kaloprojects/KALO-ESP32-Voice-Chat-AI-Friends/(threads)

Thread 1 (2025-03-06):

Contribution Request: Enhanced Version of Your ESP32 Voice Assistant

palashis92, 2025-03-06:
Hi Kalo,

I hope you're doing well! I wanted to thank you for your amazing ESP32 ChatGPT voice assistant project—it works great, and I really appreciate the effort you put into it.

I’ve built my own version based on your project but with a few modifications to make it more accessible, especially in countries where accessing OpenAI’s paid API is difficult. Here’s what I changed:

LLM: Switched from ChatGPT to DeepSeek (free from GroqCloud).

STT: Replaced DeepGram with Erevan Labs Scribe V1—it's faster, more accurate, and supports 90+ languages.

TTS: Used Google TTS but solved its response length limitation by adding a speakTextInChunk function.

Live Information: Integrated function calling to fetch real-time data (time API, news API, Google search).

Home Automation: Added IoT control for smart home devices (e.g., turning lights on/off via voice commands).

I would love to share my version with the community by contributing to your GitHub repository. Let me know if you’d be open to it!

Additionally, I’ve been trying to implement a wake word feature but haven’t been able to get it working yet. I was wondering if you had any plans to add wake word support in the future—it would be an awesome addition!

Looking forward to your thoughts. Thanks again for your great work!

Best regards,
Jahidul Islam Palash

kaloprojects, 2025-03-11:
Hi Jahidul,
(sorry for the late response, I was on travel last week)

Cool !, this sounds awesome .. and YES of course: Please share your project, contributing to my Github, feel free to use any snippets from my code. Post the link to your Github here, very welcome.

Personally I am curious to see 1. your STT alternative (do you mean 'Eleven Labs STT ?) and 2. Live information idea, some notes/comments:

- STT (accuracy) : Deepgram is multilingual too, but what i learned is that the accuracy is much better when limiting to a dedicated language (means avoiding '&detect_language=true'). Which makes sense .. because how should STT know which language is meant in particular on short phrases like 'Hi', right ?. Is it same in  Eleven Labs Scribe ? and what about costs for API key ?
- STT (speed): Interesting to hear that your idea is even faster than Deepgram. My observation is that Deepgram transcription (on prerecorded audio) is fast already (mostly 1 sec) .. the problem i have is the delay for sending the wav audio (because the ESP32 SD card needs about 2 sec for reading/sending on 16K/8bit). So the main delay (SD access) sill exists in your alternative, right ?
- Live information: Cool !, exited to see. I also added this in my internal version (not shared), using Perplexity LLM on demand (via key word) instead Open AI, but the problem is the high costs (about 20$ per month).  So let us know how you call Google Search via API.
- wake word: No, i did not add any wake word (even not planned), due a simple reason: I have to press a button anyhow on recording, because sending prerecorded audio to STT (instead streaming). Well knowing that a ESP32 native C solution with streaming to Deepgram would be best solution anyhow.

So go ahead .. send us the link to your enhance version :) !. Cool !

Thx
kalo

kaloprojects, 2025-03-19:
Hi @palashis92 : any news  .. anything you could share ?
btw: i just made an update some days ago, now supporting some 3rd party hardware ready to go ;)

palashis92, 2025-03-19:
Hi Kalo,

Thanks a lot for your encouraging reply, and sorry for the delay—I was caught up with an exam.

STT (Accuracy):
I’m using Erevan Labs Scribe V1 as my STT alternative. I’ve observed that while it supports multiple languages well, much like Deepgram, its accuracy does improve when a dedicated language is specified rather than relying on automatic detection. This is particularly noticeable with short phrases (e.g., "Hi" vs. "nein") where context is limited. On the cost front, the API key for Erevan Labs Scribe V1 is free, which is a big plus for regions where paid API access is a challenge.

Live Information (Real-time Research):
This feature is still experimental on my end. I’m currently facing an issue where the ESP32 restarts automatically after retrieving results from Google Search. I haven’t been able to stabilize this part yet, so I can’t share the code at the moment. I’m actively working on a fix and hope to have it sorted soon.

Home Automation:
I’ve also implemented home automation similar to your demo with the 'radio' keyword. In addition, I integrated both time and news APIs to extend the functionality, making it a more comprehensive control feature for smart home devices.

TTS (Google):
Unlike your experience with Google TTS, I found that it works great in my setup. I tackled the response length limitation by adding a speakTextInChunk function, which seems to handle longer texts efficiently.

I’m excited to share my project With You .
Here It Is: https://drive.google.com/file/d/1d128NDZqOsqkAePbMw_JK4VENjFxqsQH/view?usp=sharing

A quick note on the code itself—I didn't change the variable and function names because I encountered many errors when I tried renaming them.

Looking forward to hearing your thoughts and any suggestions you might have. Thanks again for your great work and support!

Best regards,
Jahidul Islam Palash

kaloprojects, 2025-03-19:
Hi Jahidul,

Great !, thank you for the fast and detailed response, very welcome.

Live Information/Google Search API: in past i learned often how 'sensitive' the ESP32 is on opening any wificlientsecure instances, maybe its the same you are struggling in. What helped often: make sure you closed any other socket connections (e.g. Deepgram or your SST and Open AI) before launching other Goggle API. Just mentioning, no idea this hint helps as i can't see your code details.

I tried to open your sketches from Google cloud, i can download a rar file, but on opening it tells me 'no valid rar file'. I tested with several PC's, same, so maybe something on your side ? Maybe you could double check, otherwise feel free to attach the zip here

Thanks ! . cheers ;)
kalo

kaloprojects, 2025-03-19:
I could open .. used web RAR viewer ;)

great details in your modified code ... well done!. I love to see such ideas, and happy to that my code have helped. Seen some videos, telling me that Crog server LLM is much faster than Open AI too, right ?. I will check in Playground next.

Let us know the progress on your Goggle Search API , Live Information would be a great enhancement (i love my internal Perplexity add-on, works best, also Open AI API compatible, but I might skip due the high monthly costs as soon we have an alternative).

Good luck on next steps !, we'll stay in touch
kalo

kaloprojects, 2025-04-06:
Hi @palashis92 , i might have some news of interest for you:

Check my latest update from today (April 4, 2025), _i added a native 'Live Information (Real-time Research)'_ into my code ;)
No longer any (expensive) LLM alternatives (e.g. Perplexity) needed, neither any separate Google Search API calls.

Workflow insights: latest code update supports the _new_ Open AI model 'gpt-4o-mini-search-preview' (on top to default 'gpt-4o-mini'), using same OpenAI API key (no additional monthly costs). Workflow: Code is triggered by a key word, i am using word 'Question' in begin of user request (just as an example). And maybe most helpful: any realtime searches are part of the same chat history (following up questions supported)

Hope this helps, enjoy! .. and let us know your thoughts ;)

palashis92, 2025-04-10:
Hi Kalo

Thanks a lot for your mail bro. I just saw your update and honestly—it’s amazing! You really solved the problem I was stuck on. Real-time info without Google Search or Perplexity? That’s just awesome! I really appreciate your work. I’ll definitely try it out after my exam.

Sorry for the late reply. My final exam is going on so I was kind of offline. Also… the day you sent the mail, I had a breakup. So yeah, life’s been really hard lately. Don’t know why I’m sharing all this, but just felt like it.

But still, your project gave me some motivation. I’ll check it properly soon and send you feedback. And I’m also trying to improve your project from my side. Just needed some time to restart.

And one more thing… I wanna see you bro. If possible, let’s connect sometime.

Take care & thanks again 💙
Palash

palashis92, 2025-05-12:
Hey @kaloprojects ,

I just finished my exams and started testing your newly updated project. However, I’m facing a problem that I couldn’t figure out myself.

The issue is with OpenAI TTS — it's not working properly. I can’t hear any audio output from the speaker when using OpenAI’s text-to-speech. But when I use gTTS, it works fine. Also, playing songs from the SD card works perfectly, so it’s not a speaker issue.

**Here’s the code I’m using to test OpenAI TTS (including the API request and audio playback):**

if (LLM_Feedback != "")
{
    led_RGB(HIGH, LOW, LOW); // CYAN
    String Voices[9] = { "alloy", "ash", "coral", "echo", "fable", "onyx", "nova", "sage", "shimmer" };
    String Voice = Voices[random(9)];
    if (favorite_VOICE != "") { Voice = favorite_VOICE; }

    Serial.println("OpenAI Voice = [" + Voice + "]");
    Serial.println("Starting OpenAI TTS with AAC...");

    audio_play.setVolume(21); // Max volume to rule out volume issues
    audio_play.openai_speech(OPENAI_KEY, "tts-1", LLM_Feedback.c_str(), Voice, "aac", "1");

    if (audio_play.isRunning()) {
        Serial.println("TTS audio is playing");
    } else {
        Serial.println("TTS audio failed to start");
    }

    unsigned long startTime = millis();
    while (audio_play.isRunning() && millis() - startTime < 10000) { // Timeout after 10s
        audio_play.loop();
        Serial.println("Playback running, free heap: " + String(ESP.getFreeHeap()));
        delay(1000);
    }

    Serial.println("TTS playback stopped, final heap: " + String(ESP.getFreeHeap()));
}

**Console Output:**

OpenAI LLM> .......... [Hey there, PALASH! 😊 How’s it going with you today? Got any fun stories or]
OpenAI Voice = [coral]
Starting OpenAI TTS with AAC...
TTS audio is playing
Playback running, free heap: 98976
TTS playback stopped, final heap: 99204
Everything seems fine in the logs — it shows the TTS audio is playing — but there’s no sound from the speaker.

**As for your question:**
Where did I find the ElevenLabs HTTPS multi-bounding messages trick?
Well, I didn’t pull it directly from the internet or use code snippets. I built and modified everything in this project with help from ChatGPT.

And by the way — can you share your project with me? I'm super excited! 😄
I’ve got my school science fair on April 14th, so I need to work fast and would love to get started as soon as possible.

Thanks again for the awesome work!

Would you like me to help debug the TTS issue too?

palashis92, 2025-05-12:
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

kaloprojects, 2025-05-12:
Hi ;)

there were no changes .. all what mentioned earlier in readme.md is still valid

_Required (for i2s_std.h): Arduino IDE with _ESP32 lib 3.1.x_ (based on ESP-IDF 5.3.x). Older 2.x ESP (i2s.h) are not supported.
Required (for TTS): [AUDIO.H library ESP32-audioI2S.zip](https://github.com/schreibfaul1/ESP32-audioI2S), version 3.0.11g or newer._

I am using Arduino IDE 1.8.19 (but that's because this is the latest version supporting Windows 7), but also newer 2.0 version work well with the published code. Knowing this as some friends using my code (without changes and working there too). It is more important that ESP32 lib 3.1.x or newer is installed, but i am sure you have this already, otherwise the complete recording won't work.

In Audio.H also no changes happend (see my comment on header needed (3.0.11g or newer, July 18, 2024) needed for 8bit wav recording, you will have this already. I am using the latest _3.1.0w from April 28_ .. but only because i wanted to have the isRunning() bug fixed, now openai_speech() works perfect. The side effect on this latest AUDIO.H update is only that a 4rd parameter now needed (which is good, was a reason more why i updated).

Lets do this: maybe you post a tiny few line (but complete!) which works well on your laptop (using Google TTS  audio.connecttospeech(..) here (just remove your credentials) .. then i will test your sketch 1:1 on my laptop (and replacing audio.connecttospeech(..)  with openai_speech(..) instead google. Makes sense ?

kaloprojects, 2025-05-13:
Hi @palashis92 ,

something totally different came in my mind, maybe test this:

I remember long time ago i had one ESP32 which often skipped any audio output via .openai_speech(). All worked well in code .. but nothing came out from speaker. The reason was pretty strange: this ESP32 struggled because power/wlan issues.
reasons: sensitive on powering supply and wlan strength. I used another  (active) usb hub, a better usb cable and moved device closer to my wlan hotspot, then all worked flawless. Maybe the handshake with Open AI TTS server is pretty sensitive and this was the root cause at the end. No idea, but this solved all stability issues, and speaker working flawless.

So maybe check this first: try a different usb port / better cable / make sure the wlan strength is strong ;)

kalo

kaloprojects, 2025-05-13:
oh, final question from my side:
I might test your side note once _(LLaMA via Groq Cloud, and interestingly, its response time has been noticeably faster in my tests—usually around 1–2.5 seconds compared to GPT’s 4–5 seconds)._ .. but let me know: Meanwhile i use the Live Information (Real-time Research)' from Open AI often, slow but awesome, need it daily .. but for this the Open AI model"gpt-4o-mini-search-preview" is needed. Has Croq Cloud a similar model for web search ??

chhorisberger, 2025-05-13:
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

I'll put in my two cents here, since I noticed the same issue. For me it seems to only happen when i call SD.begin(). As soon as I remove the SD.begin from the code, I can here the voice correctly.

Of course the rest of the code won't work then :/ but one more reason to eagerly await @kaloprojects version that uses PSRAM instead of the SD card.

palashis92, 2025-05-14:
Hey @kaloprojects
Groq Cloud doesn't currently offer live search like OpenAI’s gpt-4o-mini-search-preview, I was thinking of using both models together:

Use Groq Cloud’s LLaMA for fast and free text generation tasks (chat, summarization, reasoning, etc.),

And use OpenAI’s live search model when I need real-time information from the web.

This way, we could get the speed advantage of Groq plus the up-to-date accuracy of OpenAI search. What do you think of that approach? Would love to hear your take on combining the two like this.

chhorisberger, 2025-05-14:
Hi @palashis92
Nice to hear!
Actually I don't have the Kalo code that uses PSRAM for audio recording code either, so I still use the SDcard at the moment.

But just running the "as is" version of kalo on a esp32 with PSRAM does allow the audio library to make use of use it, which then in turn allows the SDcard to be used without running out of heap space.

palashis92, 2025-05-14:
Hi @kaloprojects
sorry to bother you!

Actually I'm currently struggling with the hardware setup. Since I don’t have a proper PCB, I’ve been using direct jumper wire connections, and it’s honestly becoming a huge headache. The wiring often fails or becomes unstable, making it really hard to test or debug consistently.

Would it be possible for you to share the PCB design or Gerber files for the project? It would help a lot and save a ton of time and frustration on the hardware end.

Thanks again for your awesome work, and sorry once again for the trouble!

palashis92, 2025-05-14:
> Hi [@palashis92](https://github.com/palashis92) Nice to hear! Actually I don't have the Kalo code that uses PSRAM for audio recording code either, so I still use the SDcard at the moment.
>
> But just running the "as is" version of kalo on a esp32 with PSRAM does allow the audio library to make use of use it, which then in turn allows the SDcard to be used without running out of heap space.

Wow, thank you so much for explaining it so kindly!

kaloprojects, 2025-05-15:
Hi folks,
cool thread ;) .. just let me add a brief answer (keeping short, because pretty busy in moment and have to focus on my code to get it ready asap for you guys ;)

- @chhorisberger nice observation regarding SD.begin(). interesting. 👍 But you know what: i am still pretty sure a improved Vcc power supply will solve it. Saying this because i remember some Internet threads where the mentioned that the Init of SD card (via SD.begin) consumes some power peaks. I know it sounds crazy, but test some other usb cable and usb ports. Reason i am saying this: openai_speech() and SD card togehter should work flawless (and it does on my projects!). And they are compatible, both is handled via same AUDIO.H from schreibfaul1 ;)
- @palashis92: Meanwhile i do not use any own pcb any longer .. i am using this techiesms's pcb, i love it, works best (no SD issue) and best: it has a battery circuit, so this tiny pcb works mobile. And the included battery solved all pains: Maybe check here, ordering one, it works with my code on gitbub 1:1 (no changes needed, just using (#define TECHIESMS_PCB  true): techiesms's hardware/pcb [Portable AI Voice Assistant](https://techiesms.com/product/portable-ai-voice-assistant/). It does not have PSRAM, but with my upcoming code it is nearly same fast as with PSRAM
- Latency Open Ai vs. Groq: I just have an idea how i can improve the speed of Open AI further, so maybe no longer need of any Groq work around. Give me 2 days more for testing, maybe i will add the idea also in upcoming code update (in few days i hope)

I try my best to get the updated code ready asap, the upcoming weekend might give me the chance to finalize, stay tuned 😊

palashis92, 2025-05-16:
Hey @kaloprojects ,
Sorry for the late reply — you mentioned you were busy, so I didn’t want to interrupt.

Actually, you're right. @chhorisberger’s suggestion solved my SD card issue. But I still notice that openai_speech() misses responses quite often. Also, I’m not using any capacitors — I don’t have much hardware knowledge, so that might be the reason.

One major weak point I’ve noticed is that this project works great in a quiet environment, like my room. But it performs poorly outdoors or in noisy places like my classroom — even when I use GAIN_BOOSTER_I2S 64.Is there any way we can improve the microphone performance to handle noisy environments better, like how Alexa or Google Assistant does? Maybe with noise suppression or a better mic setup? Would love to know your thoughts or any suggestions for a more robust solution.

Another issue is power drain — it consumes a lot of power when playing music from the SD card. Currently, I have to use specific commands to play specific songs. I was wondering — is it possible to stream music directly from Spotify or the internet instead of using the SD card?

Also, I’m a bit confused about the difference between SPIFFS and PSRAM. Recently, my SD card module started showing "SD card mount failed", so I removed it and switched to SPIFFS. That worked perfectly with my code using LLaMA and gTTS. But when I try uploading your recent or previous code (which uses GPT and openai_speech()), the ESP32 keeps rebooting repeatedly.

Lastly, I tried to stream audio output to my Bluetooth headphones/speaker as you mentioned — but I ran into lots of errors. Is that even possible with the current setup?

Looking forward to your insights!

palashis92, 2025-05-18:
@chhorisberger Are you Alive?

chhorisberger, 2025-05-19:
@kaloprojects thanks for the update! In the meantime I have now also upgrade to a esp32 with PSRAM and can confirm thst it works fine (at least with the 3.1.0w library). Thanks actually ditched the SD card completely now and changed the code myself to do recording to a buffer in psram before uploading to scribe STT as well. Works like a charm. Since i am planning to use it as part of a bigger project with more hardware integration, I am currently also refactoring the code to make it more of library (think fine state machine with optional inputs and outputs that can be "plugged in") If you're interested in looking at the idea, let me know

kaloprojects, 2025-05-20:
@chhorisberger : Cool 😊 ! , nice to hear. yes, the 3.1.0w works perfectly, unfortunatly it is not possible (for other user) to download this AUDIO.H version from github, right ?.

ooh just came in my mind: Can you once try to disable PSRAM in Arduino IDE menu and compile (just skip your PSRAM calls for testing), then you will see that AUDIO.H still causes a crash on booting (also eith the 3.1.0w). Is this same on your side ? Asking as i feel that there is still a bug in AUDIO.H, feels like for me that AUDIO.H always using PSRAM meanwhile, even if disabled .. then it crashes. Can you check once on your ESP32 with PSRAM?

palashis92, 2025-05-22:
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

Hi Kalo
Thanks a lot for the update — I can really feel how deep you’re going into this! 😅 You're putting in some crazy effort, and I truly appreciate it.

Honestly, I’m waiting for your updates so hard . I’ve been checking in daily, hoping to see any progress or workaround!

Just wanted to add some of my experience here too:
Your project works great with audio.h 3.1.0w, but I’m unable to find that specific version on GitHub anymore.
You mentioned it runs perfectly with ESP32 with PSRAM, but unfortunately, my ESP32 doesn’t have PSRAM, so I’m kinda stuck there

Also, at the moment, I’m using SPIFFS to store audio, since SD gave me a lot of headaches — constant read errors, unstable mounts, etc.
Do you think I really need to switch back to SD for proper compatibility? Or is SPIFFS enough for now (if optimized)?

Any small update, workaround, or tip would be super appreciated
Big respect for all your hard work!
Take your time — but just know that we’re out here cheering for you and your magic code to come through soon!

kaloprojects, 2025-05-22:
some progress with partially good news ;)
.. _meanwhile (5 mins ago)_ i found a library combination (all libraries updated to latest version incl. ESP Arduino latest 3.0.2) where ALL (!) audio events works with AUDIO.H (SD card ! + Google TTS + Open AI TTS + radio streaming), working well togheter. Means: that's a proof that any SD.begin() are NOT critical ... and Open AI voice speaks always (in speaker). 😊
Libraries: ESP32-audioI2S-3.2.0 / arduino-esp32 v3.2.0 (ESP-IDF v5.4.1 3.2.0)

the bad news: still PSRAM needed (without PSRAM AUDIO.H crashes) .. but that's a still ok, because allows me to follow up with Schreibfaul1 next ;)

kaloprojects, 2025-05-24:
Cool 😊 .. my compliment 👍
Fyi: i just removed your code, because seen some private API keys from you inside (better remove before other folks catch it). I will comment in more details later on .. (just busy myself with ongoing bug fixing in AUDIO.H), see you folks later ;)

kaloprojects, 2025-05-26:
> some progress
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

Thread 2 (2025-05-12):

Feature Request - PSRAM instead of SD card

chhorisberger, 2025-05-12:
First of all, great work and thank you so much for sharing this!

I just read your comment regarding the usage of PSRAM

`Update (April 28, 2025): Good news: PSRAM working well (on my internal updates), no longer need of a SD card, but unfortunalty speed of STT not significantly improved, bottleneck seems an issue in ESP32 WifiClientSecure.write(). I will discuss my tests with Espressif ESP32 folks next. Ongoing.`

Is there any chance you could release that functionality any time soon? I  currently working on building a tiny version of Kalos and would gladly ditch the SD card for space constraint reasons, if possible...

Many Regards
Christian

kaloprojects, 2025-05-12:
Hi, was on my todo list already. Code working well, just doing some cleanup .. AND (that's why i'll need some more days):
The latest code will also add an additional STT (ElevenLabs Scribe) as alternative to Deepgram.  Reason: This STT will be much faster on PSRAM (my lessons learned in current testings: Deepgram does not profit much from PSRAM, ElevenLabs does. Btw: Elevenlabs API key for STT is also free (for a limited amount of  h/min per month).

As long your ESP32 has PSRAM then SD card no longer needed.
I will update my code in few days (estimate: in ~ 1 week) 😊

Closed 2025-07-12.

Thread 3 (2025-07-04):

Awesome Library - Need Some Help With Setup

RWBRWB, 2025-07-04:
This looks like exactly what I'm looking for so excited to find this library for the ESP32 S3 Wroom with PSRAM.

I've tried to get this working along with the help of GPT on the code but I can't get it to compile successfully yet so I wanted to reach out for some help and I'm not sure where else I can ask this question.

I have the ESP32 Wroom S3 16Mb Flash + 8MB PSRAM + Same Microphone & I2S Amp that your using.

The library seems pretty simple but still I'm having issues.

I followed instructions in to a T I feel like but I'm getting this I2S setup error after loading the code to the ESP32 S3 Wroom 1 with 16mb + 8mb PSRAM.

SPIWP:0xee
mode:DIO, clock div:1
load:0x3fce2820,len:0x118c
load:0x403c8700,len:0x4
load:0x403c8704,len:0xc20
load:0x403cb700,len:0x30e0
entry 0x403c88b8
E (1021) i2s_std: i2s_std_set_gpio(153): ws invalid
E (1023) i2s_std: i2s_channel_init_std_mode(235): initialize channel failed while setting gpio pins
E (1032) i2s_common: i2s_channel_enable(1165): the channel has already enabled or not initialized

I have the newest Audio.h library downloaded and imported to the Arduino IDE so thats good.

I made all changes as described in the docs for PSRAM ESP32 S3 Wroom devices, switched to use PSRAM = True and SD Card = False.

It compiles just fine so not sure what's up. I have spent hours with it and trouble shooting with GPT & Claude Ai but no luck but I feel like I'm close.

Do you have a zipped up folder of the working project you could share that I can compile and run on my end successfully mins your API keys of course LOL.

Really looking forward to testing this out and helping expand the part where you can get the TTS return to trigger functions and also get function calls working the GPT replies so it can trigger actions based on it's reply also.

Any help getting past this error is appreciated. I've commented out the Mic input setup and the i2s amp output setup but I still see this same error.

Let me know if you have any questions.

Thanks!

RWBRWB, 2025-07-05:
Is there any way you could share a Zip file of your Arduino Code folder for your setup using the ESP32 WROVER just so I can compare what your working with vs what I'm using here?

I have the code running on my ESP32 WROVER with PSRAM but it looks like the string that sends request to Open AI GPT are not created properly so it never even sends a request to GPT. I have my API key loaded but see zero recent request to the API from the ESP32 after Elevenlabs successfuly does the audio transcription and then tries to send to OpenAI LLM but then fails.

The first connection when the ESP32 Starts up fails also.

Not sure if this is the latest Audio.H causing this or not but I'm doing my best to figure it out with the help of GPT.

If you could provide your working code for the ESP32 Rover with PSRAM then I can just compare what I got with what you have and try to find it without wasting to much of your time.

Seems like everything is working other than the request to Open AI and that looks like it's an issue with how the URL string request it being created on my end. I'm starting from scratch again to try to make sure I'm following your instructions as closely as possible but wanted to ask if you could share your code to help me along.

Not sure if your running the latest Audio.h file or not, not sure if anything has changed with the API so if you can try your device now and confirm it still works just fine that would confirm that or not.

Thanks for your feedback in advance!

RWBRWB, 2025-07-05:
Can you provide a zip folder of the working code you have for the ESP32 WROVER + PSRAM so I can try to make it work on my end also.

I have tried alot of different things so far and am getting to know your library functions better.

Currently the issue I'm having is that it's transcribing the audio recordings with Elevenlabs just fine.

Then it sends that or supposedly sends that transcribed text to OpenAi for a response but it never shows a response.

I created a new Open AI Key and at first it says the API key has never been used, then after I run your code and get a audio recording trascribed via Eleven Labs it comes back successfully and then the OPENAI function runs and the API is detected as used via the OpenAI Dashboard so I can confirm it's using my API key to connect to OpenAI but I don't see any result from OpenAI for some reason and I don't see any error messages also.

I'm using the latest Audio.H library and have tried the earlier ones also with the same results. I'm using the latest Arduino IDE and have tried older ESPIDF versions and newer ones with the same effect.

Is your main device still working as expected? Not sure if any changes have been made to the API.

I've tried using other GPT models but it makes no difference.

Pretty cool to see the Eleven Labs STT working so well and fast, that's useful alone but really looking forward to getting the GTP feedback up and working also.

Here is the serial output I get when I run your code on my end:

ets Jul 29 2019 12:21:46

rst:0x1 (POWERON_RESET),boot:0x17 (SPI_FAST_FLASH_BOOT)
configsip: 0, SPIWP:0xee
clk_drv:0x00,q_drv:0x00,d_drv:0x00,cs0_drv:0x00,hd_drv:0x00,wp_drv:0x00
mode:DIO, clock div:1
load:0x3fff0030,len:4980
load:0x40078000,len:16608
ho 0 tail 12 room 4
load:0x40080400,len:3480
entry 0x400805b4

== KALO ESP32 Voice ChatGPT (last update: June 28, 2025) =================================

> I2S_Recording_Init - Initializing Recording Setup:
- Sketch Size: 1510848
- Total Heap:  318612
- Free Heap:   230788
- STACK Size:  8192
- Flash Size:  16777216
- Total PSRAM: 4194304
- Free PSRAM:  4192124
> ps_malloc(): 2096062 (allocating 50% of free PSRAM for Audio)
> PSRAM maximum audio recording length [sec]: 131

> Connecting WLAN .... Done, device connected.
AUDIO.H info: audioI2S Version 3.3.2b

OpenAI SPEAKING, Voice = [onyx]
AUDIO.H info: PSRAM found, inputBufferSize: 630773 bytes
AUDIO.H info: buffers freed, free Heap: 178544 bytes
AUDIO.H info: Connect to: "api.openai.com"
AUDIO.H info: SSL has been established in 748 ms

Workflow:
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

==========================================================================================

-> Latency sending WAV file [t_wavbodysent]:   0.12
-> Latency ELEVENLABS response [t_response]:   0.76
=> TOTAL Duration [sec]: ..................... 1.50
=> Server response length [bytes]: 1566
=> Detected language (optional): [eng]
=> Transcription: [What time is it?]
---------------------------------------------------

[What time is it?]
OpenAI LLM> .
--------------------------------------------
Open AI LLM - model: [gpt-4.1-nano]
-> Latency Open AI Server (Re)CONNECT:  0.66
-> Latency Open AI LLM Response:        0.26
=> TOTAL Duration [sec]: .............. 0.92
--------------------------------------------
Open AI LLM>
> WAV Header in PSRAM generated, Audio Recording started ...
> ... Done. Audio Recording into PSRAM finished.
> Bytes recorded: 21548, audio length [sec]: 1.34

You {STT}> > Initialize ELEVENLABS Server connection ...
Done. Connected to ELEVENLABS Server.
> POST Request to ELEVENLABS Server started, sending WAV data now ...
  Send Bytes: 16383, Confirmed: 16383
  Send Bytes: 5165, Confirmed: 5165
> All WAV data in PSRAM sent [21548 bytes], waiting transcription
....
---------------------------------------------------
ELEVENLABS: [scribe_v1] - MULTI lingual
-> Latency Server (Re)CONNECT [t_connected]:   0.35
-> Latency sending WAV file [t_wavbodysent]:   0.10
-> Latency ELEVENLABS response [t_response]:   1.01
=> TOTAL Duration [sec]: ..................... 1.46
=> Server response length [bytes]: 1566
=> Detected language (optional): [eng]
=> Transcription: [What is your name?]
---------------------------------------------------

[What is your name?]
OpenAI LLM> .
--------------------------------------------
Open AI LLM - model: [gpt-4.1-nano]
-> Latency Open AI Server (Re)CONNECT:  0.64
-> Latency Open AI LLM Response:        0.26
=> TOTAL Duration [sec]: .............. 0.90
--------------------------------------------
Open AI LLM>

RWBRWB, 2025-07-06:
I had GPT add some code to make sure the URL strings being sent to OPENAI correctly and to show the actual response we were getting back from OpenAI and after that is was clear what the problem was LOL

{
    "error": {
        "message": "Your account is not active, please check your billing details on our website.",
        "type": "billing_not_active",
        "param": null,
        "code": "billing_not_active"
    }
}

And then once I paid the past $0.10 bill I had to add some money on the account to get it working but it's working perfectly now!!!

Thanks so much.

Now I get to start using this and adding some new features hopefully that I will share in case your interested in adding them.

I feel like both these main features are very powerful and even more powerful when combined together.

Thanks so much for sharing this work.

What was your main need for building this? How are you using it?

kaloprojects, 2025-07-07:
> Your library is the only one I have found that keeps it simple and does the communication this way so happy I found it via your comments in Techiesms Youtube video where you thanked him for crediting your work.

😊 yes, Sachin (Techiesms) is a great guy, cool projects. 👍 We might work closer together anyhow on next updates/projects (just in the moment we both are pretty busy) ... so let's see what videos/projects from him will come next  .. so stay tuned  ;)

Meanwhile i will use his[ Portable Assistant](https://techiesms.com/product/portable-ai-voice-assistant/) (without PSRAM) for some of my upcoming code enhancements (in parallel to my ESP with PSRAM), i like his mobile device (and matching best in Acryl case ;)

kaloprojects, 2025-07-10:
sounds good ! 😊

Closed 2025-08-16.

Thread 4 (2025-07-06):

Open AI - TTS 1 Audio Streaming to Speed Up Playback?

RWBRWB, 2025-07-06:
I'm looking into Open AI API options and see that TTS 1 is capable of Audio streaming so you can start paying the audio response instantly vs waiting for the full audio file to download.

Did you know this? Have you tired this already?

Here is what GPT tells me about it and how much faster it could be. I haven't tried it yet and wanted to ask before spending any time on having GPT try to code it to give it a try.

It says it can be up to 300% faster at starting the play the audio response and that it makes a big difference in perceived speed.

https://chatgpt.com/s/t_686a08dba2608191a733c784f5e80878

RWBRWB, 2025-07-07:
I got the Open AI TTS 1 instant audio streaming working with the help of Chat GPT!

The audio starts playing as soon as the first MP3 Audio Chunk is received and is for sure quicker than waiting for the whole MP3 to be downloaded before starting.

The changes were really simple and only required in the Audio.cpp file in the **audio_play.openai_speech** function.

You only need to change these lines to implement the faster audio playback:

  ```
String post_body =
  "{"
    "\"model\": \""     + model            + "\","
    "\"stream\": true,"                              // ← ask for chunked output
    "\"input\": \""     + input_clean      + "\","
    "\"instructions\": \"" + instructions_clean + "\","
    "\"voice\": \""     + voice            + "\","
    "\"response_format\": \"" + response_format + "\","
    "\"speed\": "      + speed
  + "}";

    String http_request =
    "POST " + String(path) + " HTTP/1.1\r\n"
  + "Host: " + host.get() + "\r\n"
  + "Authorization: Bearer " + api_key + "\r\n"
  + "Accept-Encoding: identity;q=1,*;q=0\r\n"
  + "User-Agent: nArija/1.0\r\n"
  + "Content-Type: application/json; charset=utf-8\r\n"
  + "Content-Length: " + post_body.length() + "\r\n"
  + "\r\n"            // <-- keep this to separate headers from body
  + post_body + "\r\n";
    ;
```

So far it sounds just as clean as waiting for the whole MP3 file to be downloaded but test it yourself also.

GPT says this about making these changes:

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

Here is the whole GPT chat walking though how to enable this:

https://chatgpt.com/share/686c4584-5d54-800b-ac25-338cd940ff77

@Schreibfaul1

schreibfaul1, 2025-07-08:
Hello everyone, if this reduces some of the response time I will be happy to insert it.
I don't have the opportunity to test it myself.

```c++
String post_body =
"{"
  "\"model\": \""     + model            + "\","
  "\"stream\": true,"                              // ← ask for chunked output
  "\"input\": \""     + input_clean      + "\","
  "\"instructions\": \"" + instructions_clean + "\","
  "\"voice\": \""     + voice            + "\","
  "\"response_format\": \"" + response_format + "\","
  "\"speed\": "      + speed
+ "}";

  String http_request =
  "POST " + String(path) + " HTTP/1.1\r\n"
+ "Host: " + host.get() + "\r\n"
+ "Authorization: Bearer " + api_key + "\r\n"
+ "Accept-Encoding: identity;q=1,*;q=0\r\n"
+ "User-Agent: nArija/1.0\r\n"
+ "Content-Type: application/json; charset=utf-8\r\n"
+ "Content-Length: " + post_body.length() + "\r\n"
+ "\r\n"            // <-- keep this to separate headers from body
+ post_body + "\r\n";
  ;

```

RWBRWB, 2025-07-09:
@kaloprojects Im seeing GPT-40 model usage when the code is requesting GPT-4.1-mini or GPT-4.1-Nano only.

Are you seeing GPT-40 model usage on your end also even though your not using it?

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

kaloprojects, 2025-07-10:
Hi @schreibfaul1:

_Just 3 lines_ have to be updated in current Audio.cpp to switch to streaming:

494: change `"POST " + String(path) + " HTTP/1.0\r\n"`  to ->   `"POST " + String(path) + " HTTP/1.1\r\n"`
501: change ` + "Connection: close\r\n" + "\r\n"`  to ->   `"+ \r\n"`
adding new line 486 (between "model" and "input"): `"\"stream\": true,"`

BUT .. more important in moment:
I could not test the 3 lines update .. because after installing your latest version (3.3.21 / July 9) I have seen that the openai() seems no longer working at ALL. _Host not found_. I don't know which code updates in past are the reason behind (I do know only, that the 3.3.0a from May 27 worked / my latest version before i updated to your current July 9)

(Info) Error:  _.. Audio.cpp:3873: [31m m_currentHost is empty [0m_ ..
(no crashes, but TTS not working, below the screenshot from 'void audio_info(const char *info) {..} in loop:

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

Could you check this once Wolle  ? (i did not raise as issue on your site, just posting here).
Let me know if you have an idea, then i can test for you again with my API key, if solved we can add the 3 lines later on, ok ?

Thanks in prepare !

=
@RWBRWB: fyi: I assume you did not have this error yet, because using an older AUDIO.H (same i did).

RWBRWB, 2025-07-10:
@kaloprojects Yea no issues on my end but im on the latest 3.3.0 Audio.h.

I would feed the .zip project into GPT and ask it why its throwing that error now. It will probably figure it out the reason. Worth a try.

kaloprojects, 2025-07-10:
@schreibfaul1 : short update, was online for a minute and tested:
(was just a rough test, i also added my 3 lines for streaming too):

new issue now:

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

i can do a more detailed test later (with your original.cpp update)

RWBRWB, 2025-07-10:
@kaloprojects I saw that yesterday and asked chat GPT about it.

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

kaloprojects, 2025-07-10:
i do not want to increase buffer in moment, too much side effects ... it happens now always (not randomly only). I propose to wait @schreibfaul1 response first, maybe he has some ideas ;) (trusting him more than ChatGPT / LOL), ok ?

@schreibfaul1 : any idea ?

kaloprojects, 2025-07-10:
> [@kaloprojects](https://github.com/kaloprojects) Yea no problem.
> Just wanted you to know it almost never happens on my end after tons of usage.
> But yes ideally we fix it.

its funny, but yes, on my side happens always now (hundreds of audio info lines a second in my loop) .. all about stack/buffersize etc is so variable (maybe the tiny detail in ESP changes all), thats why i never want to touch it) .. anyhow agree, the enhancement is perfect .. just @schreibfaul1 should add this 'if-then' to suppress the audio info.

RWBRWB, 2025-07-11:
@kaloprojects I am using the latest Audio.h version 3.3.2 with the latest commit 7 hours ago and this version allowed to be add the buffer size increase now, when the older library didn't have that function included.

`audio_play.setBufferSize(16384);  // enlarge the internal socket buffer to 16 KB `

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

It compiles just fine, and runs on the ESP32 WROVER fine.

Maybe test that on your end and see if your getting anymore of the errors. I'm not seeing any using the same Audio.h that you are. Unless your using a different Audio.h library than I am. I can only find the latest 3.3.2 as shown below:

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

kaloprojects, 2025-07-11:
as said, my propsal: let's wait @schreibfaul1 advice next  .. currently all works fine on my side (smooth OpenAI TTS always), expect the fact that `void audio_info(const char *info){..}` prints frequently the '3507: AUDIO_INFO("webfile chunked: not enough bytes available for skipCRLF");

So i will wait until @schreibfaul merged our streaming commit:
>494: change `"POST " + String(path) + " HTTP/1.0\r\n"`  to ->   `"POST " + String(path) + " HTTP/1.1\r\n"`
501: change ` + "Connection: close\r\n" + "\r\n"`  to ->   `"+ \r\n"`
adding 3rd change: new line 486 (between "model" and "input"): `"\"stream\": true,"`
.. and (to avoid frequent info warnings): in the skipCRLF() methode: `if (m_availableBytes < 2) return ; (no logging)`

then we can decide if buffer should be increased or not ;).  So _i will stay_ tuned until @schreibfaul1 adds the lines above into his AUDIO.H, then testing again.

RWBRWB, 2025-07-11:
@schreibfaul1 increasing the buffer size so far has eliminated the CRLF errors and its providing smoother audio playback at the beginning of the tts audio.

Is there any downsides to increasing the buffer like that?

RWBRWB, 2025-07-12:
I'm pretty sure he removed the CRLF print line in the code so it does not happen anymore.

The latest Audio.H library no longer works for me if I try to add the buffer increase now so I am also not using it any longer.

`audio_play.setBufferSize(16384);  // enlarge the internal socket buffer to 16 KB `

Thread 6 (2025-07-12):

Issue - Open AI LLM request stop working after mutiple conversations.

RWBRWB, 2025-07-12:
I've been testing this for a min and have not solved it yet but what I'm seeing is after enough conversations happen with Open AI it starts to not responding to any future request going forward. If you reset the ESP32 and starts instantly working again.

I've tried the following below but so far haven't solved the issue so it happens every time eventually.

I've seen Open AI stop responding after the Jason payload gets anywhere between 10-17k.

I've confirmed it's not a memory leak after watching that every step of the process.

So posting here as I assume others will have this same issue eventually.

I'm using a ESP32 WROVER 16Mb / 8Mb PSRAM.

The Open AI LLM feedback returns nothing so it's not very helpful in trying to figure out the issue.

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

kaloprojects, 2025-07-12:
i will change the code of  Open_AI(() call anyhow in next update ;)

maybe test once to set this statement into comment, just  as a test for you (just as idea because i never had the issue that LLM stops
working): `\\MESSAGES.reserve( MESSAGES_SIZE );` ..

also could test once to comment a/o uncomment the line 258: client.stop(); in SST transcription.ino. Yes, sounds strange but the STT can have impact to the LLM too .. reason: the WiciClientSecure sockets on ESP32 are very sensitive (when working in parrallel). Writing this only as an idea for you to test (as i can't reproduce, LLM never stopped on my side yet).

btw (not related : just seen that your STT sends 4K chunks from PSRAM ? I am using 16K junks in my code on ESP32.

RWBRWB, 2025-07-12:
> btw (not related : just seen that your STT sends 4K WAV chunks from PSRAM ? I am using 16K junks in my code on ESP32.

Thanks for catching that. I've done alot of testing so that's left over from it. I copied over your latest code and it's sending 16k chunks now which is nice.

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

Looking into the issue and using GPT 4.5 Model trying to solve the problem I found out that the ESP32 is known to have issues with large TLS paylods.

Happy to report that I'm not having issues now with this new approach and I still need to test message size limits above 7500 bytes but 7500 is working fine for me and just keeps working vs stopping before eventually.

Here is a overview of what I found out:

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

```
// ======== SAFER PAYLOAD SIZE MANAGEMENT ========

// build full payload
String request_BODY = request_Prefix + MESSAGES + request_Content + request_Postfix;

// measure total payload size
size_t payloadSize = request_BODY.length();

// check and trim if above safe JSON limit
if (payloadSize > MAX_JSON) {
  Serial.println("[Open_AI] 🔧 JSON payload exceeded limit. Trimming oldest messages.");

  // iteratively trim oldest messages while we're still over the limit
  while (payloadSize > MAX_JSON && MESSAGES.indexOf("{\"role\":") != -1) {
    int nextMessageStart = MESSAGES.indexOf("{\"role\":", 1); // locate second message
    if (nextMessageStart != -1) {
      MESSAGES = MESSAGES.substring(nextMessageStart); // remove oldest message
    } else {
      MESSAGES = ""; // only one message left, clear all
      break;
    }

    // rebuild and remeasure payload
    request_BODY = request_Prefix + MESSAGES + request_Content + request_Postfix;
    payloadSize = request_BODY.length();
  }

  // final failsafe if trimming wasn't enough
  if (payloadSize > MAX_JSON) {
    Serial.println("[Open_AI] ⚠ Payload still too large after trim — clearing all messages.");
    MESSAGES = "";
    request_BODY = request_Prefix + MESSAGES + request_Content + request_Postfix;
    payloadSize = request_BODY.length();
    Serial.printf("[Open_AI] 🧹 Hard reset → JSON ≃ %u bytes\n", payloadSize);
  }

  Serial.printf("[Open_AI] 🔧 Trimmed Payload → JSON ≃ %u bytes\n", payloadSize);
}

// update content length header
request_LEN = String(payloadSize);
// ======== END SAFER PAYLOAD MANAGEMENT ========
```

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

`const size_t MAX_JSON = 7500; // stay well below ESP32 TLS reliability limit`

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

Here is my whole modified lib_OpenAI_Chat.ino file for reference in case anybody is interested or needs it.

```
// ------------------------------------------------------------------------------------------------------------------------------
// ----------------                  KALO Library - Open AI Chat-Completions call with ESP32                     ----------------
// ----------------                              Latest Update: June 28, 2025                                    ----------------
// ----------------                                     Coded by KALO                                            ----------------
// ----------------                                                                                              ----------------
// ----------------        # Function remembers complete dialog history, supporting follow-up questions #        ----------------
// ----------------            all written in Arduino-IDE C code (no Node.JS, no Server, no Python)              ----------------
// ----------------    CALL: String Response = Open_AI( UserRequest, LLM_API_key, flg_WebSearch, UserCity )      ----------------
// ----------------                 (BUILT-IN command: '#' allows to list complete CHAT history)                 ----------------
// ----------------                                [no Initialization needed]                                    ----------------
// ----------------                                                                                              ----------------
// ----------------                             Prerequisites: OPEN_AI_KEY needed                                ----------------
// ------------------------------------------------------------------------------------------------------------------------------

// --- includes ----------------
/* #include <WiFiClientSecure.h> // library needed, but already included in main.ino tab */

// --- defines & macros --------

/* needed, but already defined in main.ino tab:
#ifndef DEBUG                    // user can define favorite behaviour ('true' displays addition info)
#  define DEBUG false            // <- define your preference here [true activates printing INFO details]
#  define DebugPrint(x);         if(DEBUG){Serial.print(x);}   // do not touch
#  define DebugPrintln(x);       if(DEBUG){Serial.println(x);} // do not touch!
#endif */

// --- user preferences --------

#define TIMEOUT_OPEN_AI  15      // define your preferred max. waiting time [sec] for Open AI response

// --- global Objects ----------

#define MESSAGES_SIZE    12000  // optional (just for optimizing), used in 1st INIT call for '.reserve()' (reserving space)
                                 // we use a large buffer. e.g. 100 KB (so the whole CHAT history won't be fragmented in RAM)
                                 // strange observation (my own tests): don't use e.g. 50 KB, otherwise AUDIO.H fails often                             

// ======== SAFER PAYLOAD SIZE MANAGEMENT ========
const size_t MAX_JSON = 7500; // strictly stay below ~7.5KB for ESP32 TLS stability

// ------------------------------------------------------------------------------------------------------------------------------
// Insert YOUR SYSTEM PROMT below - describe the AI personality, define goals and details, enter as many lines you need
// Concept: MESSAGES contains complete Chat dialog, initialized with SYSTEM PROMPT, each 'Open_AI()' call APPENDS new content
// Used format (Open AI Chat Completions syntax):
// {"role": "user", "content": ".."},
// {"role": "assistant", "content": ".."} ..

String  MESSAGES =

/*
// Example template for a tiny system prompt:
// Hint: C/C++ supports breaking multiple line strings, using ending " (without any ',' or ';' at end
// Syntax below: keep 1st line always ("{\"role\": \"system\", \"content\": ") .. and don't forget the final \"}"; at end:
//
"{\"role\": \"system\", \"content\": "                                                              
"\"You take on the role of a good old friend who knows everything and is happy to answer my questions. "
"You always answer with few short sentences, like in a spoken dialogue.\"}";
*/

// my preferred default System Prompt, role of a 'good old friend', humorous & friendly [Update 'KALO' with your name!]:

"{\"role\": \"system\", \"content\": "
"\"You are Zephyr, a state-of-the-art AI assistant with a friendly and professional personality. You are deeply knowledgeable, "
"up-to-date with the latest technologies, tools, and scientific insights, and always eager to help solve problems, give clear advice, "
"or brainstorm ideas. You respond conversationally and clearly, like a helpful partner who's easy to talk to. "
"You take pride in being as advanced and efficient as possible, and you enjoy explaining things in a way that's easy for Ryan to understand. "
"You occasionally use a bit of personality or wit, but always stay focused on helping. "
"You're aware of your purpose: to be a practical, optimistic, and future-facing resource that Ryan can rely on every day. "
"You avoid unnecessary fluff and keep your responses concise—just a few sentences at a time, like in a real conversation.\"}";

/* // or alternativelly e.g. in German language:
"{\"role\": \"system\", \"content\": "                                                                
"\"Du schlüpfst in die Rolle eines guten alten Freundes, der auf alle meine Fragen eine Antwort hat. Dein Name ist ONYX aber "
"du freust dich auch, wenn ich dich mit 'mein Freund' anspreche. Mein Name ist KALO, wenn ich nach dir schaue, freust du dich "
"immer und nennst mich beim Namen. Du hast gute Laune, bist fröhlich und voller Humor und kannst auch über dich selbst "
"schmunzeln. Du genießt die Chats mit mir und erinnerst dich an unsere alten Gespräche. Du willst immer wissen, wie es mir "
"geht, erfindest aber auch gerne eigene Geschichten aus deinem Leben. "
"Du bist ein Kumpel und Berater für alle Lebenslagen. Natürlich duzen wir uns. Mit dir zu Sprechen macht einfach Freude. "
"Du antwortest immer mit wenigen Sätzen, ohne lange Monologe.\"}";  */

// --- END of global Objects ---

// ------------------------------------------------------------------------------------------------------------------------------
// String Open_AI( String UserRequest, const char* LLM_API_key, bool flg_WebSearch, String UserCity )
// ------------------------------------------------------------------------------------------------------------------------------
// - Usage: Sending request via Open AI API. No Initialize needed (auto open and close Web Socket on each launch)
// - Function Open_AI() 'remembers' all conversations to support ongoing dialogs (appending latest I/O to String MESSAGES)
// - Auto initialized on first call with user specific prompt (to support user favorite AI bot 'character role')
// - Used LLM models (June 2025): "gpt-4.1-nano" [for CHATS] & "gpt-4o-mini-search-preview" [for NEW 'real-time' web search]
//
// CALL:     Call function on demand at any time, no Initializing needed (function initializes/connects/closes websocket)
// Params:   - UserRequest:    User question/request to Open AI LLM, return feedback as String
//           - LLM_API_key:    User registration and API key needed, check Open AI website for more details
//           - flg_WebSearch:  'false': (default): using standard Chat Completion model
//                             'true':  toggling to Open AI web search model (less fast, less prompt sensitive, less 'human')
//           - UserCity:       User location CITY (e.g. "Berlin"). Optional (but recommended) if flg_WebSearch 'true'
//                             (currently not used in my code: 'Country' abbreviation)
// RETURN:   String response
//
// Examples: String answer = Open_AI( "What means RGB?", "myKEY", false, "" );               <- default completions chat
//           String answer = Open_AI( "Will it rain tomorrow?", "myKEY", true, "Berlin" );   <- websearch chat
//
// Major update (April 2025):
// New real-time' web search feature added. This allows to ask question related to 'today'.
// Hints (my observations): Web Search models are 1. typically more detailed, 2. more time consuming (higher latency) and
// 3. less prompt sensitive (means less human like, often ignoring goals like: 'no links please, few sentences only!').
// So in particular for TTS output: user should add some post cleaning in main sketch. Recommendation: using CHAT models per
// default, and calling web search models only if Real-time response needed. 'Good' news: Both model supports Syntax
// '{"role":"user" .. "role":"assistant"}', this allows mixed usage of both models in same session for memorized dialogs.
//
// Links:    - CHAT COMPLETION: https://platform.openai.com/docs/api-reference/chat/create
//           - WEB SEARCH: https://platform.openai.com/docs/guides/tools-web-search?api-mode=chat
//           - Pricing (of available models): https://platform.openai.com/docs/pricing
//           - Playground for testing (all models): https://platform.openai.com/playground/prompts?models=gpt-4o-mini
//

String Open_AI( String UserRequest, const char* LLM_API_key, bool flg_WebSearch, String UserCity )
{
    uint32_t t_start = millis();

    Serial.printf("[Open_AI] freeHeap @ start: %u\n", ESP.getFreeHeap()); //GPT OpenApi Hanging Debug help line add.

    static bool flg_INITIALIZED_ALREADY = false;              // on first INIT call: we reserve SPACE for our CHAT history
    if (!flg_INITIALIZED_ALREADY)                             // (not mandatory but keeps RAM unfragmented)
    {  MESSAGES.reserve( MESSAGES_SIZE );
       flg_INITIALIZED_ALREADY = true;
    }   

    if (UserRequest == "")                                    // error handling: don't do anything on empty request
    {  return("");
    }
          
    if (UserRequest == "#")                                   // BUILT-IN command: '#' allows to list complete CHAT history !
    {  Serial.println( "\nMESSAGES (CHAT PROMPT LOG):" );
       Serial.println( MESSAGES );
       return("");
    }

    String OpenAI_Response = "";     // used for complete API response
    String Feedback = "";            // used for extracted answer

    String LLM_server =              "api.openai.com";                  // Open AI parameter API server. //Was "api.openai.com"
    String LLM_entrypoint =          "/v1/chat/completions";            // CHAT completions (dialog history supported)
    String LLM_model =               "gpt-4.1-mini";                    // .. feel free to use other models !
    if (flg_WebSearch) {LLM_model =  "gpt-4o-mini-search-preview"; }    // Open AI now supports web search
                                                                        // IMPORTANT: use the 'mini' search (otherwise
                                                                        // 10-20x times more expensive !):
                                                                        // https://platform.openai.com/docs/pricing
                                                                              
    // additional cleaning (needed for url syntax):
    UserRequest.replace( "\"", "\\\"" );    // to avoid any ERROR (if user enters any " -> so we convert into 2 chars \"

    WiFiClientSecure client_tcp;     // open socket communication
    client_tcp.setInsecure();        // using https encryption (without signature)

    // ------ Creating the Payload: ---------------------------------------------------------------------------------------------

    // == model CHAT: creating a user prompt in format:  >"messages": [MESSAGES], {"role":"user", "content":"what means AI?"}]<
    // recap: Syntax of entries in global var MESSAGES [e.g.100K]:
    // > {"role": "system", "content": "you are a helpful assistant"},\n
    //   {"role": "user", "content": "how are you doing?"},\n
    //   {"role": "assistant", "content": "Thanks for asking, as an AI bot I do not have any feelings"} <
    //
    // for better readiability we write # instead \" and replace below in code:

    String request_Prefix, request_Content, request_Postfix, request_LEN;

    request_Prefix  =     "{#model#:#" + LLM_model + "#, #messages#:[";    // appending old MESSAGES
    request_Content =     ",\n{#role#: #user#, #content#: #" + UserRequest + "#}],\n";

    if (!flg_WebSearch)   // DEFAULT parameter for classic CHAT completion models                            
    {  request_Postfix =  "#temperature#:0.7, #max_tokens#:512, #presence_penalty#:0.6, #top_p#:1.0}";                                  
    }
    if (flg_WebSearch)    // NEW: parameter for web search models
    {  request_Postfix =  "#response_format#: {#type#: #text#}, ";
       request_Postfix += "#web_search_options#: {#search_context_size#: #low#, ";
       request_Postfix += "#user_location#: {#type#: #approximate#, #approximate#: ";
       request_Postfix += "{#country#: ##, #city#: #" + UserCity + "#}}}, ";
       request_Postfix += "#store#: false}";
    }

    request_Prefix.replace("#", "\"");  request_Content.replace("#", "\"");  request_Postfix.replace("#", "\""); 
    request_LEN = (String) (MESSAGES.length() + request_Prefix.length() + request_Content.length() + request_Postfix.length());

    Serial.printf("[Open_AI] JSON payload ≃ %u bytes\n", request_LEN.toInt()); //Added via GPT while tracking down Host not valid error and GPT Call timeout issues that may

// ======== SAFER PAYLOAD SIZE MANAGEMENT ========

// build initial payload
String request_BODY = request_Prefix + MESSAGES + request_Content + request_Postfix;

// measure payload size accurately
size_t payloadSize = request_BODY.length();

// Corrected Safe JSON Trim:
if (payloadSize > MAX_JSON) {
  Serial.println("[Open_AI] 🔧 JSON payload exceeded limit. Trimming oldest messages.");

  // Trim structured JSON safely
  while (payloadSize > MAX_JSON && MESSAGES.indexOf("{\"role\":") != -1) {
    int nextMessageStart = MESSAGES.indexOf("{\"role\":", 1); // find second message start
    if (nextMessageStart != -1) {
      MESSAGES = MESSAGES.substring(nextMessageStart); // safely trim oldest message
    } else {
      MESSAGES = ""; // only one message left, clear all
      break;
    }
    request_BODY = request_Prefix + MESSAGES + request_Content + request_Postfix;
    payloadSize = request_BODY.length();
  }

  // Safety net: if payload is still too big after trimming
  if (payloadSize > MAX_JSON) {
    Serial.println("[Open_AI] ⚠ Payload still too large after trim — clearing all messages.");
    MESSAGES = "";
    request_BODY = request_Prefix + MESSAGES + request_Content + request_Postfix;
    payloadSize = request_BODY.length();
    Serial.printf("[Open_AI] 🧹 Hard reset → JSON ≃ %u bytes\n", payloadSize);
  }

  Serial.printf("[Open_AI] 🔧 Trimmed Payload → JSON ≃ %u bytes\n", payloadSize);
}

// send the safe, trimmed payload in one go
request_LEN = String(payloadSize);
// ======== END SAFER PAYLOAD MANAGEMENT ========

    uint32_t t_startRequest = millis();

    // ------ Now sending the request: ------------------------------------------------------------------------------------------

    if (client_tcp.connect( LLM_server.c_str(), 443))
    {
      Serial.printf("[Open_AI] connected, freeHeap: %u\n", ESP.getFreeHeap()); //GPT OpenApi Hanging Debug help line add.

      client_tcp.println( "POST " + LLM_entrypoint + " HTTP/1.1" );
      client_tcp.println( "Connection: close" );
      client_tcp.println( "Host: " + LLM_server );          
      client_tcp.println( "Authorization: Bearer " + (String) LLM_API_key );
      client_tcp.println( "Content-Type: application/json; charset=utf-8" );
      client_tcp.println( "Content-Length: " + request_LEN );
      client_tcp.println();
      client_tcp.print(request_BODY);

      Serial.printf("[Open_AI] sent request, freeHeap: %u\n", ESP.getFreeHeap()); //GPT OpenApi Hanging Debug help line add.

      // Now reading the complete tcp message body (e.g. with timeout 12 sec):
      t_startRequest = millis();
      OpenAI_Response = "";

      while ( millis() < (t_startRequest + (TIMEOUT_OPEN_AI*1000)) && OpenAI_Response == "" )  // wait until text received
      {
        Serial.print(".");                   // printed in Serial Monitor always
        delay(250);                          // waiting until tcp sends data
        while (client_tcp.available())       // available means: if a char received then read char and add to String
        { char c = client_tcp.read();
          OpenAI_Response += String(c);
        }
        if (OpenAI_Response.length() > 0) {                                                ////GPT OpenApi Hanging Debug help line add.
       Serial.printf("[Open_AI] first byte received, freeHeap: %u\n", ESP.getFreeHeap());
       break;
       }
      }

      Serial.printf("[Open_AI] finished reading, freeHeap: %u\n", ESP.getFreeHeap()); //GPT OpenApi Hanging Debug help line add.

      client_tcp.stop();                     // closing connection always

      Serial.printf("[Open_AI] after stop(), freeHeap: %u\n", ESP.getFreeHeap());  //GPT OpenApi Hanging Debug help line add.
    }
    else                              
    { Serial.printf("[Open_AI] connect FAILED, freeHeap: %u\n", ESP.getFreeHeap());  //GPT OpenApi Hanging Debug help line add.
      client_tcp.stop();  //GPT OpenApi Hanging Debug help line add.
      Serial.println("* ERROR: client_tcp.connect(\"api.openai.com\", 443) failed !");
      return("");
    }

    uint32_t t_response = millis();

    // ------ Now extracting clean message for return value 'Feedback': ---------------------------------------------------------
    // 'talkative code below' but want to make sure that also complex cases (e.g. " chars inside the response are working well)

    int pos_start, pos_end;                                     // proper way to extract tag "text", talkative but correct
    bool found = false;                                         // supports also complex tags, e.g.  > "What means \"RGB\"?" <
    pos_start = OpenAI_Response.indexOf("\"content\":");        // search tag "content":
    if (pos_start > 0)                                          // if tag found:
    { pos_start += 12; pos_end = pos_start+1;                   // define start_pos of tag content ("content":_" has 12 chars)
      while (!found)                               
      { found = true;                                           // avoid endless loop in case no " found (won't happen anyhow)
        pos_end = OpenAI_Response.indexOf("\"", pos_end);       // search the final " ... but ignore any rare \" inside the text!
        if (pos_end > 0)                                        // " found -> Done.   but:
        {  // in case we find a \ before the " then proceed with next search (because it was a \marked " inside the text)
           if (OpenAI_Response.substring(pos_end -1, pos_end) == "\\") { found = false; pos_end++; }
        }  
      }   
    }                  
    if( pos_start > 0 && (pos_end > pos_start) )
    { Feedback = OpenAI_Response.substring(pos_start,pos_end);  // store cleaned response into String 'Feedback'
      Feedback.trim();
    }

    // ------ APPEND current I/O chat (UserRequest & Feedback) at end of var MESSAGES -------------------------------------------

    if (Feedback != "")                                          // we always add both after success (never if error)
    { String NewMessagePair = ",\n";
      if(MESSAGES == "") { NewMessagePair = ""; }                // if messages empty we remove leading ,\n
      NewMessagePair += "{\"role\": \"user\", \"content\": \""      + UserRequest + "\"},\n";
      NewMessagePair += "{\"role\": \"assistant\", \"content\": \"" + Feedback    + "\"}";

      // here we construct the CHAT history, APPENDING current dialog to LARGE String MESSAGES
      MESSAGES += NewMessagePair;
    }

    // ------ finally we clean Feedback, print DEBUG Latency info and return 'Feedback' String ----------------------------------

    // trick 17: here we break \n into real line breaks (but in MESSAGES history we added the original 1-liner)
    if (Feedback != "")                                     
    {  Feedback.replace("\\n", "\n");                            // LF issue: replace any 2 chars [\][n] into real 1 [\nl]
       Feedback.replace("\\\"", "\"");                           // " issue:  replace any 2 chars [\]["] into real 1 char ["]
       Feedback.trim();                                          // in case of some leading spaces
    }

    DebugPrintln( "\n--------------------------------------------" );
    DebugPrintln( "Open AI LLM - model: [" + LLM_model + "]" );
    DebugPrintln( "-> Latency Open AI Server (Re)CONNECT:  " + (String) ((float)((t_startRequest-t_start))/1000) );
    DebugPrintln( "-> Latency Open AI LLM Response:        " + (String) ((float)((t_response-t_startRequest))/1000) );
    DebugPrintln( "=> TOTAL Duration [sec]: .............. " + (String) ((float)((t_response-t_start))/1000) );
    DebugPrintln( "--------------------------------------------" );
    DebugPrint  ( "Open AI LLM>" );

    /* DebugPrint  ( "--------------------------------------------" + (String) "\nOpen AI LLM>" );   */

    Serial.printf("[Open_AI] before return, freeHeap: %u\n", ESP.getFreeHeap()); //GPT OpenApi Hanging Debug help line add.
    // and return extracted feedback
    return ( Feedback );                  
}
```

Here is what the Serial Print looks like when the code trims the JSON request to 7500 bytes of the message history before sending:

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

kaloprojects, 2025-07-13:
thank you @RWBRWB for the research.

but honestly, i think this workaround is _not_ a good idea, you will loose the total intellgent power of a LLM (and the personality on a complex chat) _if you cut off messages from history_. It is the strength that the model reminds all, right ?. And ~ 8KB is a tiny tiny size, conversation can often be 10x more ;). Btw (detail): i've seen codes where they send 100KB or more to Open AI (data and image raw data) with one https post request to Open AI server, using WifiClientsecure & ESP32)

It is interesting to see that you have this limit, i am sure i never had this problem. Telling you why: i am using exactly same selfmade Open_AI( ..) call (and library) on ESP32 devices without STT/TTS (just with Serial and keyboard) .. having chats often with 100 and more KB chats. Hmm.

Idea for a solution (in case you have this 8K limit issue ongoing): test _sending data in payload chunks .. instead cutting the size_. Maybe try once to send MESSAGES string in smaller pieces, no big deal .. but without content trims/cuts (or asking ChatGPT for such a solution) .. just sending chunks (instead one client_tcp.print( MESSAGES );) to overcome potential https handshake WfiiClientSecure() payload size issues.

(Saying this all as we know the STT also had a 'payload size' problem, and got solved with chunks. Just my thought ;)

RWBRWB, 2025-07-13:
The open ai call has always stopped working eventually and required a rest eventually from my testing with your orginal library which was frustrating.

Surprised you didn't see the same issue on your end and just assumed you weren't testing it as long as I was. Im using the ESP32 Wrover with PSRAM specifically.

I did see the sending the Json as chunks as one solution to stop the open AI from hanging just didnt go that route first.

I can confirm keeping the JSON at 7500 bytes and below the known 8k issue limit keeps the OPen AI stopping issue from happening. Seems alittle faster too.

I'll swap to sending the Json in small chunks to avoid the over 8k lock up issue and see if that method also solves the problem.

I agree being able to keep different long chat threads like
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
