kaloprojects/KALO-ESP32-Voice-Chat-AI-Friends/(list of files, drawings)

Other design files:
hardware_pcb/KALO AI Board 20251218 - Source Master.lay6
