kaloprojects/KALO-ESP32-Voice-Chat-AI-Friends/(commit log)

2026-01-04 Update README with PCB layout preview
    Added PCB layout preview and updated README content.
2026-01-06 Update README with PCB layout images and notes
    Added additional images and notes about the PCB layout and populated components.
2026-01-07 Complete PCB instructions
    Expanded the README with detailed information about the PCB, including its features, layout, BOM, GPIO assignments, and instructions for use.
2026-01-07 Revise README for KALO AI Board summary
    Updated the README to provide a summary of the KALO AI Board and its features.
2026-01-07 Refactor RGB LED and resistor section in README
    Removed redundant resistor information for RGB LED and clarified soldering instructions.
2026-01-07 Update README with detailed PCB assembly instructions
    Clarified soldering instructions and component connections for the PCB.
2026-01-07 Enhance README with links and formatting updates
    Updated the README to include links to the FireBeetle 2 wiki and improved formatting for the BOM section.
2026-01-07 Clarify SD card module slot purpose in README
    Updated the README to clarify the SD card module slot's purpose and future use cases.
2026-01-08 Update image link in README.md for KALO AI Board
2026-01-08 Updated
    Updated README to clarify Gerber data sharing and PCB CAD file modifications.
2026-01-08 Update README with RGB LED soldering instructions
    Clarified instructions for RGB LED and resistors, emphasizing the importance of using a common Anode version and providing soldering tips for SMD components.
2026-01-11 Updated
    Updated GPIO pin assignments and improved documentation for DFRobot ESP32-S3 support.
2026-01-16 Updated installation instructions in README.md
    Added instructions for updating hardware pin assignments and audio recording settings.
2026-01-18 Fix duplicate entry and update README details
    Removed duplicate entry for GPIO pin assignments update and added a note about the SD module bug fix.
2026-01-19 Updated
    Updated README with recent GPIO pin assignments and bug fixes for DFRobot ESP32-S3. Added details on email feature and hardware support.
2026-09-16 Update
    Updated README.md to clarify AUDIO.H library usage and recommendations for ESP32 projects.
